andrey-belokon/Syntez_Si5351_Si570/README.md

Stand With Ukraine (https://stand-with-ukraine.pp.ua)
<h2>Universal Digital VFO Si570/Si5351</h2>

Oscillator - Si570 and/or Si5351<br>
CPU - Arduino Nano 5v ATMEGA328<br>
Display:<br>
  2.8" SPI TFT ILI9341<br>
  1.8" SPI TFT ST7735<br>
  LCD 1602<br>
  OLED 0.91" 128x32, OLED 0.96" 128x64, OLED 1.3" 128/132x64<br>
Realtime clock - DS3231(preffered) or DS1307(TinyRTC) or PCF8563<br>
Keyboard, BPF & other - PCF8574<br>
Rotary encoder - optical 360-400 pulse/turn or mechanical 20 pulse/turn

Allow any combination of two Si5351 and one Si570: Si5351, Si570, Si5351+Si5351, Si570+Si5351, Si570+Si5351+Si5351.<br>
Dual VFO A/B, SPLIT, RIT.<br>
Save current freq and band to EEPROM. <br>
CAT-enabled (Kenwood protocol).<br><br>
Support different TRX architecture:<br>
 1. Single and double IF superheterodyne.
 2. Up-conversion with general coverage 2-30MHz and high IF.
 3. Direct conversion with 2x or 4x output.
 4. Direct conversion with quadrature output.

Project homepage http://www.ur5ffr.com/viewtopic.php?t=174

Required libraries:<br>
 1. PDQ GFX with packed font support https://github.com/andrey-belokon/PDQ_GFX_Libs. You need install PDQ_GFX, PDQ_ILI9341 and PDQ_ST7735<br>
 2. UR5FFR_Si5351 https://github.com/andrey-belokon/UR5FFR_Si5351
 3. SSD1306Ascii - install from Arduino IDE

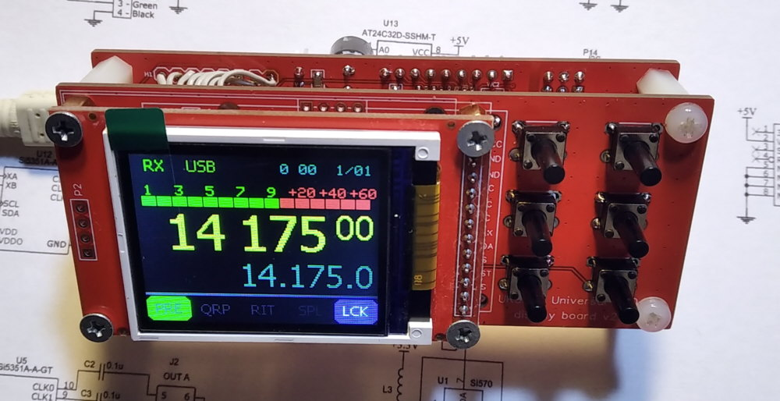
[picture p1: doc/ST7735_570_5351_two_plate/img/synt_v2_tft-10pin.jpg]

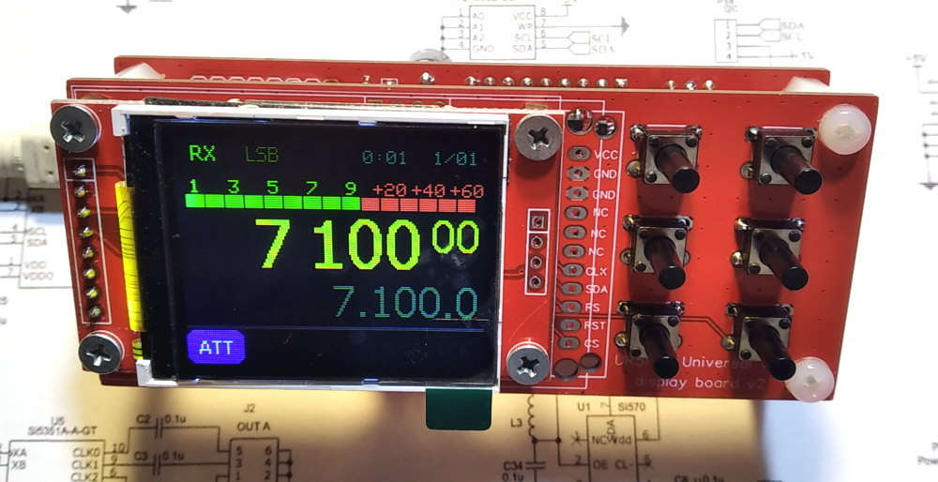
[picture p2: doc/ST7735_570_5351_two_plate/img/synt_v2_tft-8pin.jpg]

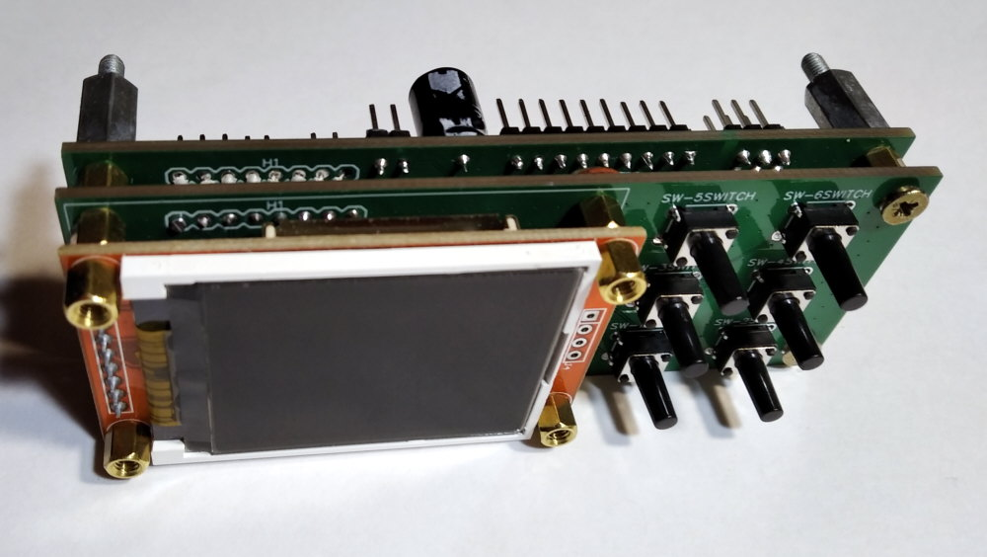
[picture p3: doc/ST7735_570_5351_two_plate/img/synt_1.8_9.jpg]

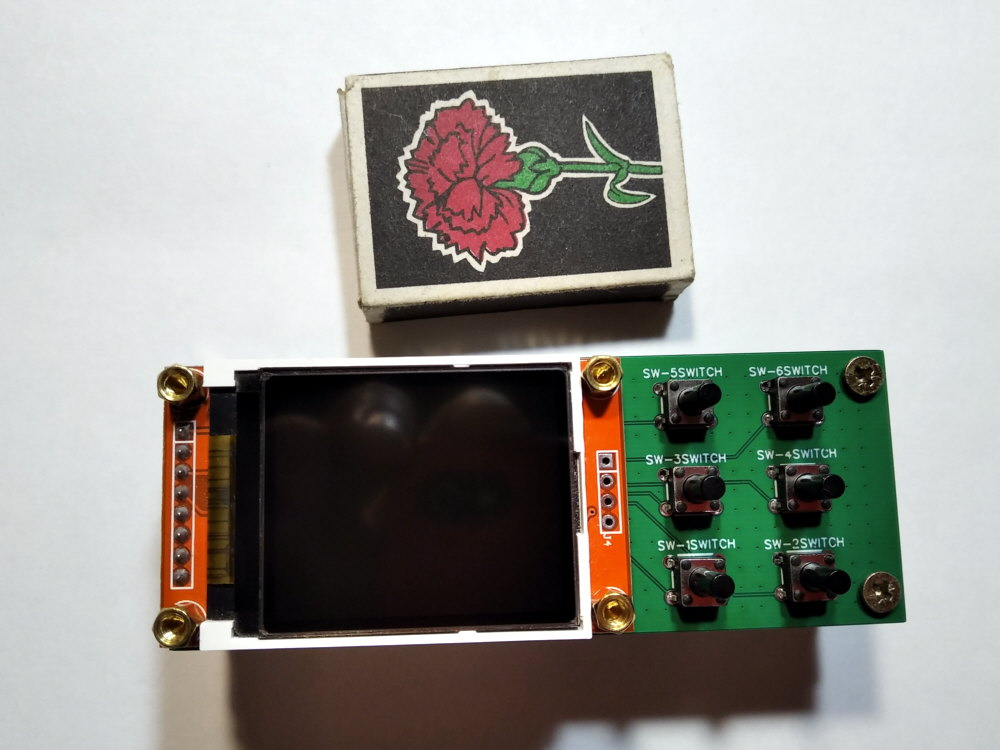
[picture p4: doc/ST7735_570_5351_two_plate/img/synt_1.8_4.jpg]

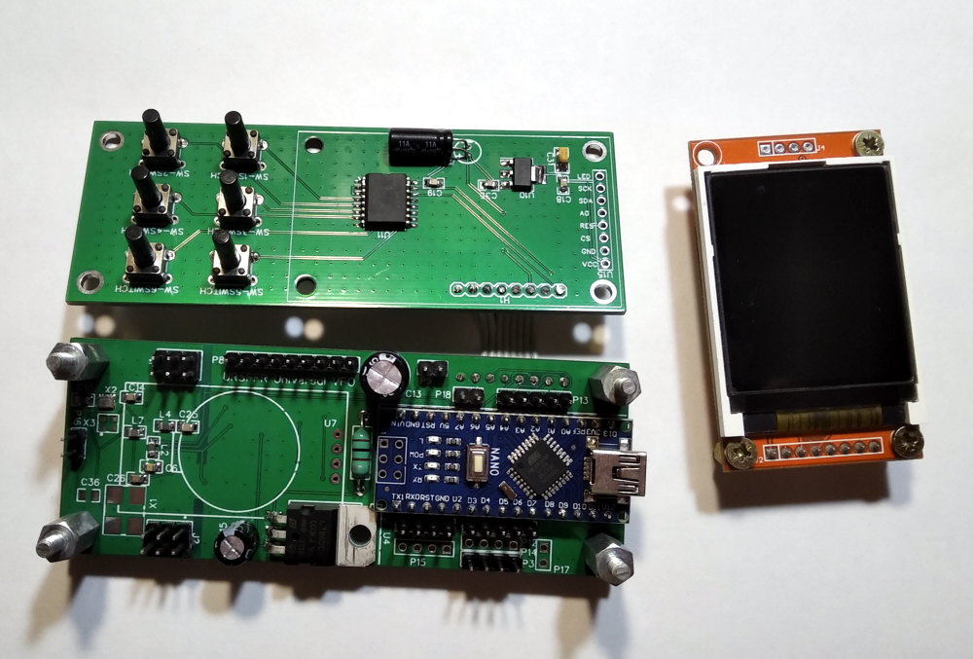
[picture p5: doc/ST7735_570_5351_two_plate/img/synt_1.8_7.jpg]


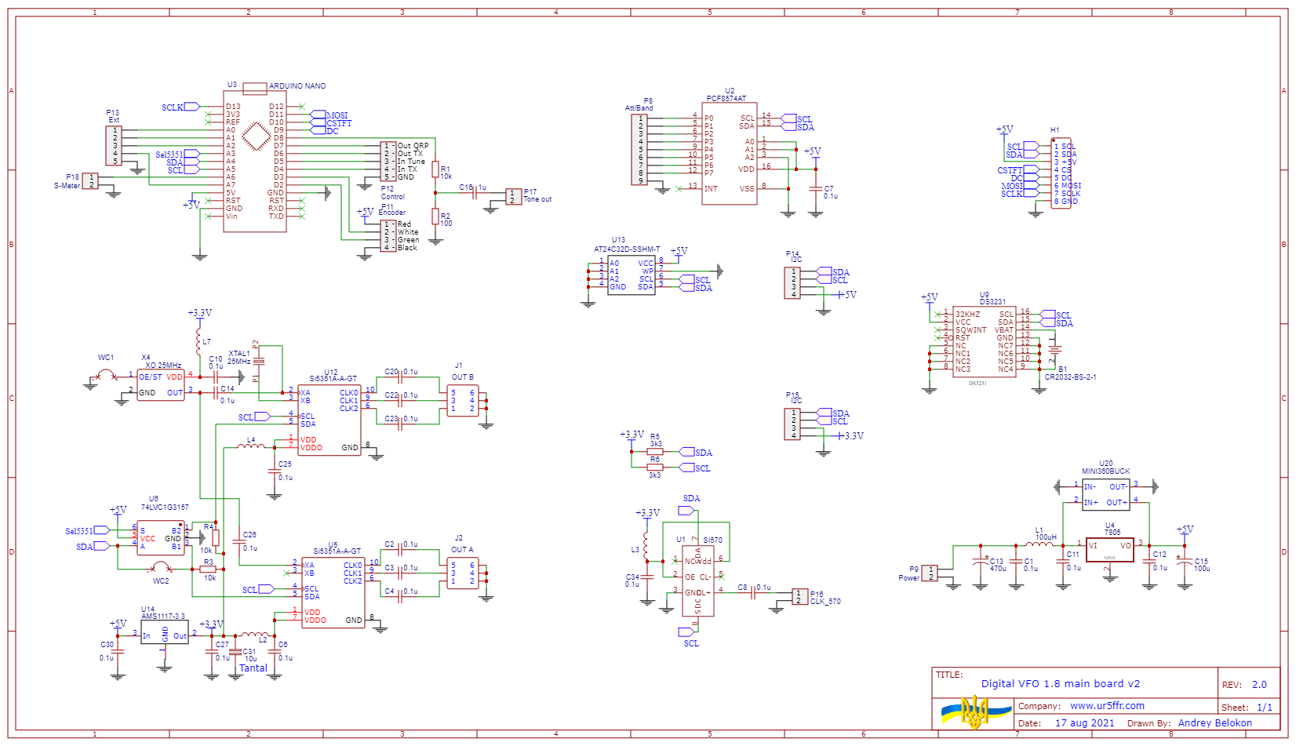
[picture p6: doc/ST7735_570_5351_two_plate/Schematic_Digital VFO 1.8 main board 2.0.png]

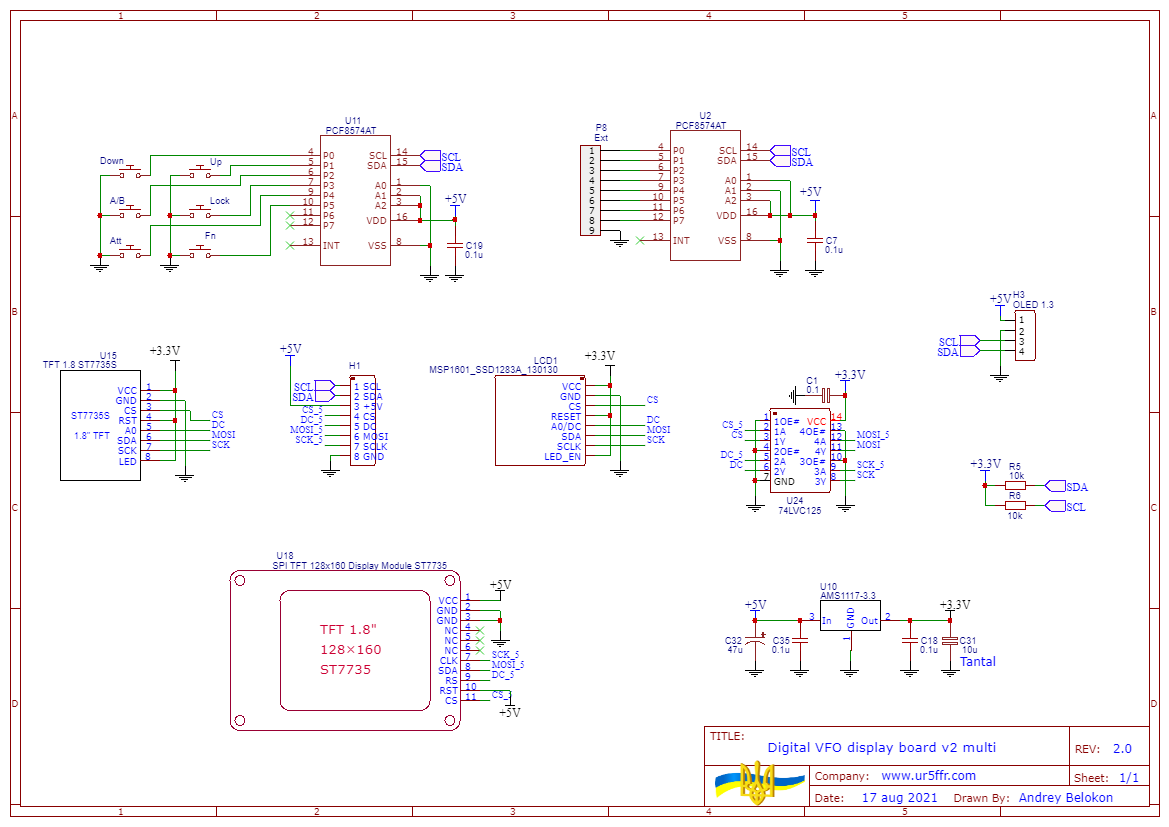
[picture p7: doc/ST7735_570_5351_two_plate/Schematic_Digital VFO 1.8 display board 2.0.png]


Copyright (c) 2016-2020, Andrii Bilokon, UR5FFR
License GNU GPL, see license.txt for more information
