andrey-belokon/Syntez_Si5351_Si570/doc/as5600_encoder.png

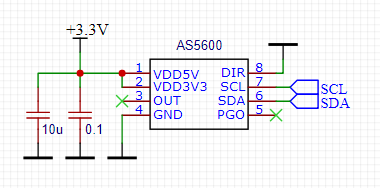
doc/as5600_encoder.png
