andrey-belokon/Syntez_Si5351_Si570/doc/Hardware/Band-control-I2C-LCD-adapter.png

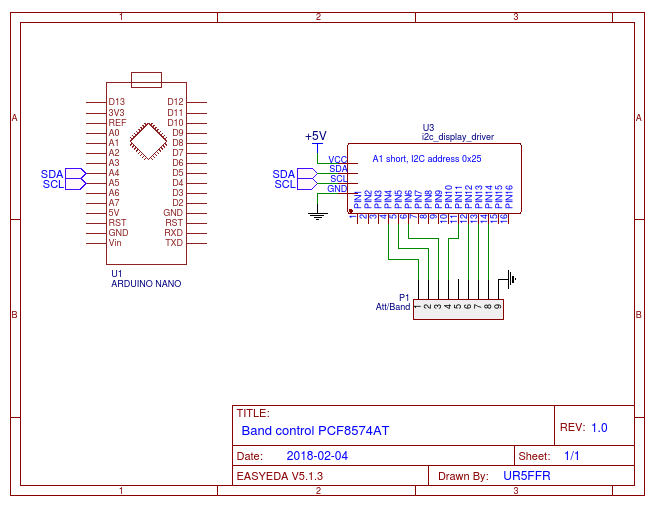
doc/Hardware/Band-control-I2C-LCD-adapter.png
