andrey-belokon/Syntez_Si5351_Si570/doc/Hardware/Band-control-PCF8574AT.png

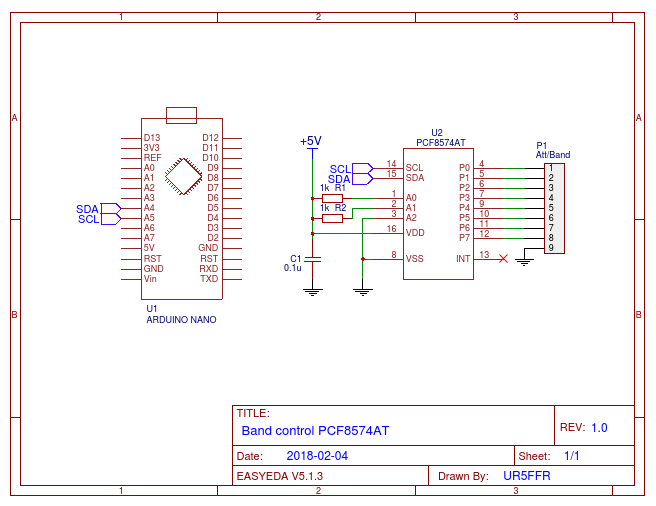
doc/Hardware/Band-control-PCF8574AT.png
