andrey-belokon/Syntez_Si5351_Si570/doc/Hardware/CPU-Pins.png

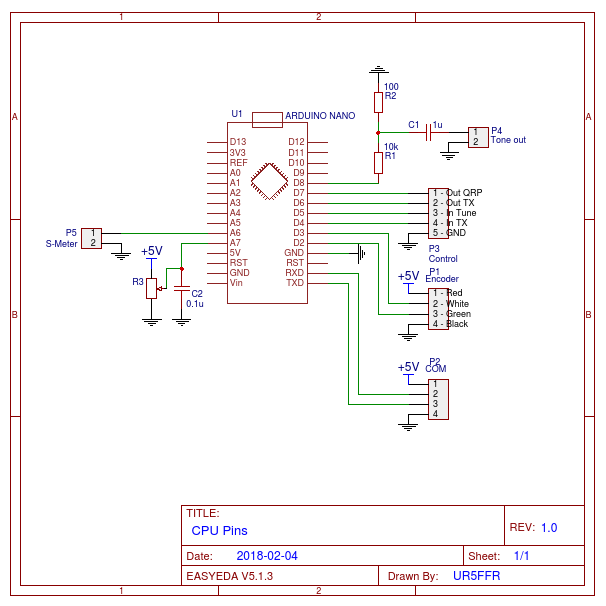
doc/Hardware/CPU-Pins.png
