andrey-belokon/Syntez_Si5351_Si570/doc/Hardware/Display-ILI9341.png

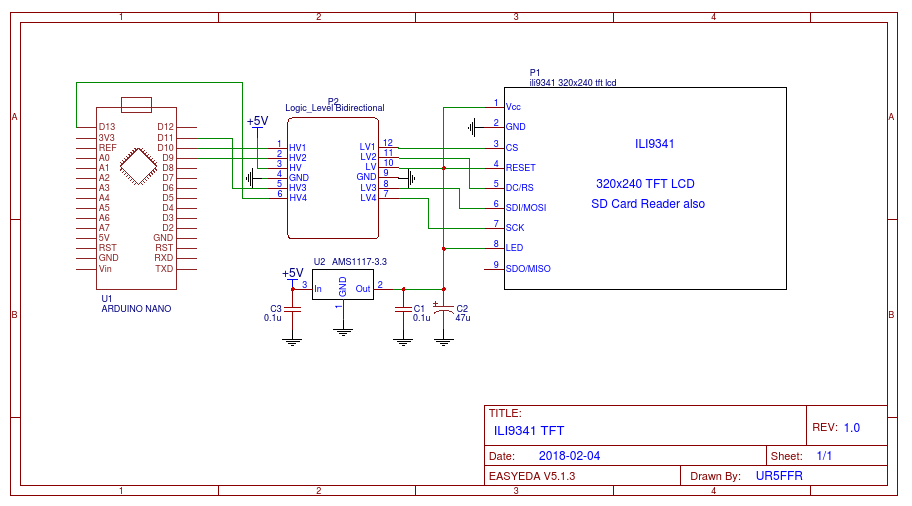
doc/Hardware/Display-ILI9341.png
