andrey-belokon/Syntez_Si5351_Si570/doc/Hardware/Display-LCD1602-I2C.png

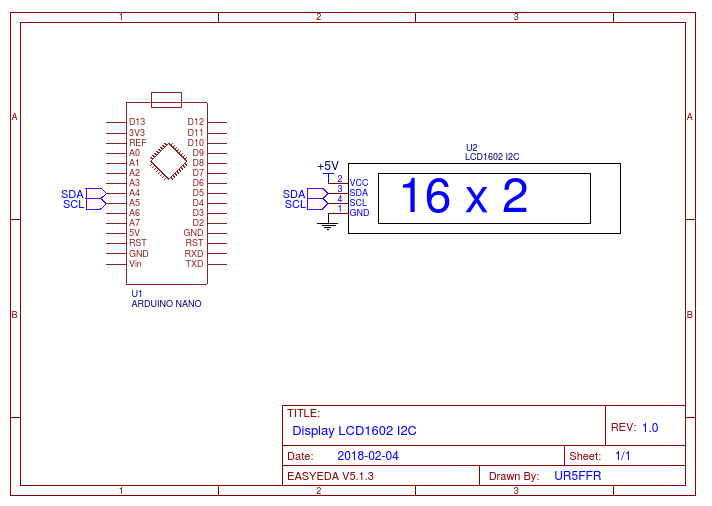
doc/Hardware/Display-LCD1602-I2C.png
