andrey-belokon/Syntez_Si5351_Si570/doc/Hardware/Display-ST7735.png

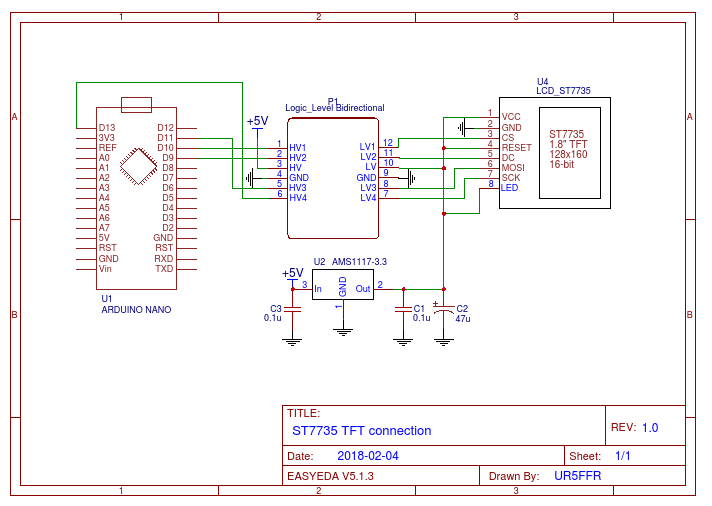
doc/Hardware/Display-ST7735.png
