andrey-belokon/Syntez_Si5351_Si570/doc/Hardware/EEPROM-24C32.png

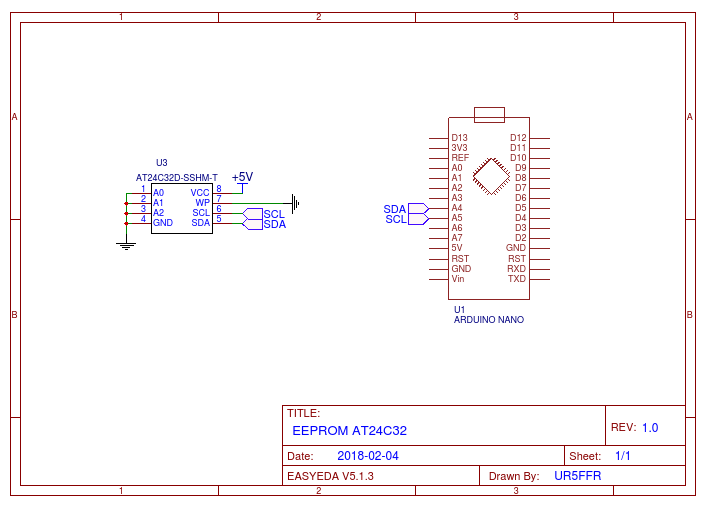
doc/Hardware/EEPROM-24C32.png
