andrey-belokon/Syntez_Si5351_Si570/doc/Hardware/Keypad-7-buttons.png

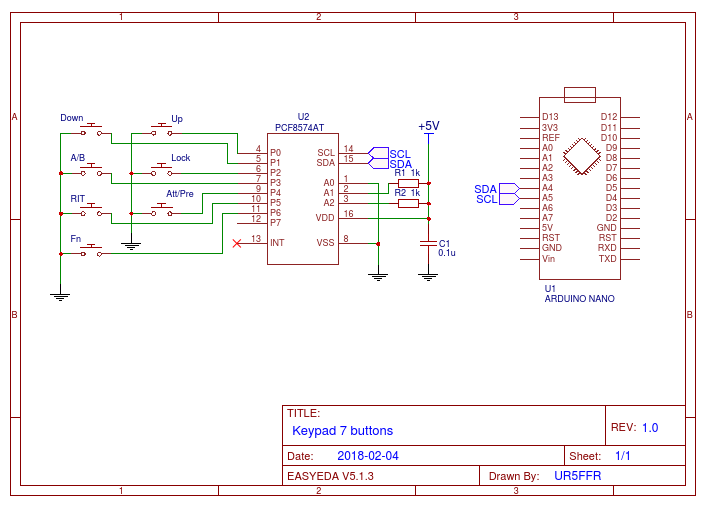
doc/Hardware/Keypad-7-buttons.png
