andrey-belokon/Syntez_Si5351_Si570/doc/Hardware/Keypad-12-buttons-3x4.png

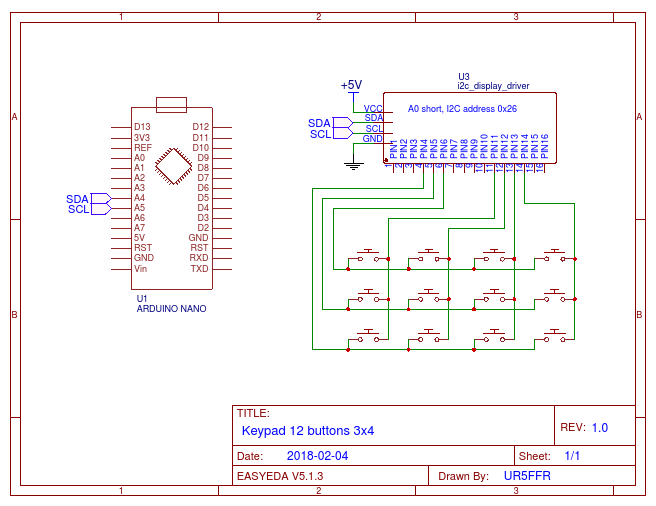
doc/Hardware/Keypad-12-buttons-3x4.png
