andrey-belokon/Syntez_Si5351_Si570/doc/Hardware/Level-translation.png

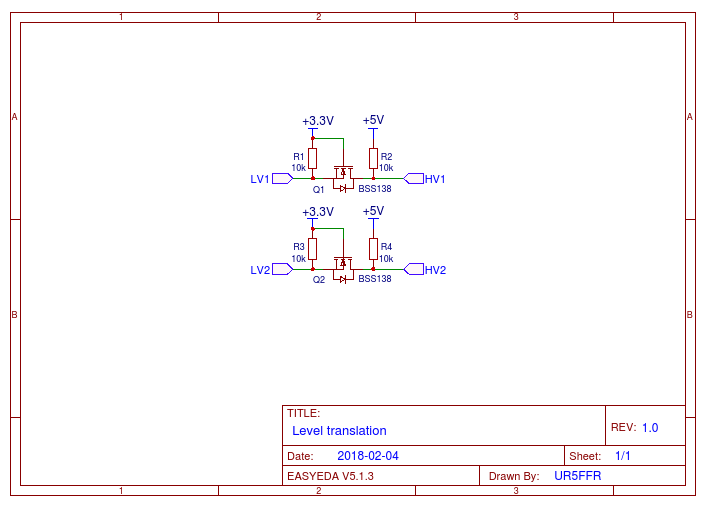
doc/Hardware/Level-translation.png
