andrey-belokon/Syntez_Si5351_Si570/doc/Hardware/Si570.png

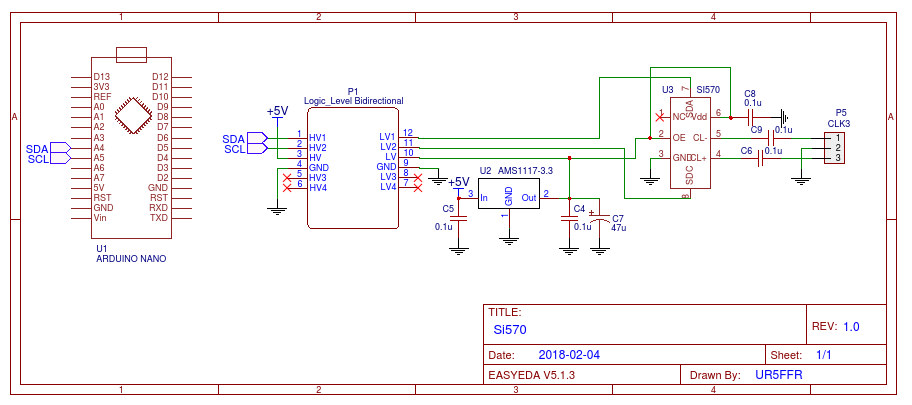
doc/Hardware/Si570.png
