andrey-belokon/Syntez_Si5351_Si570/doc/Hardware/Si5351.png

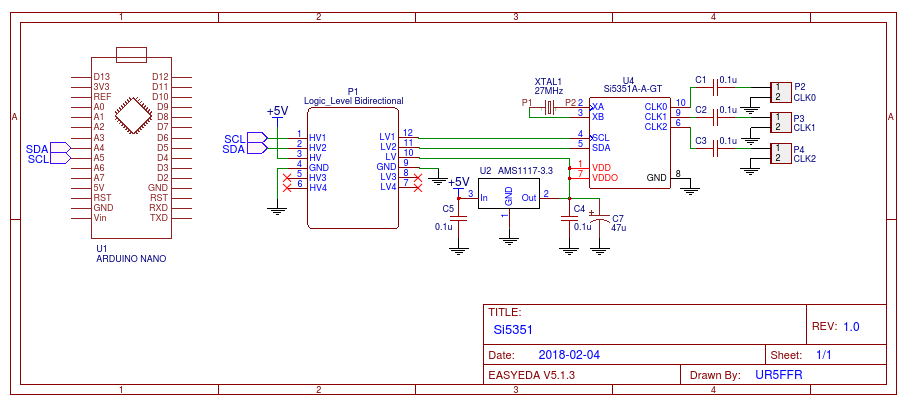
doc/Hardware/Si5351.png
