andrey-belokon/Syntez_Si5351_Si570/doc/Hardware/TinyRTC.png

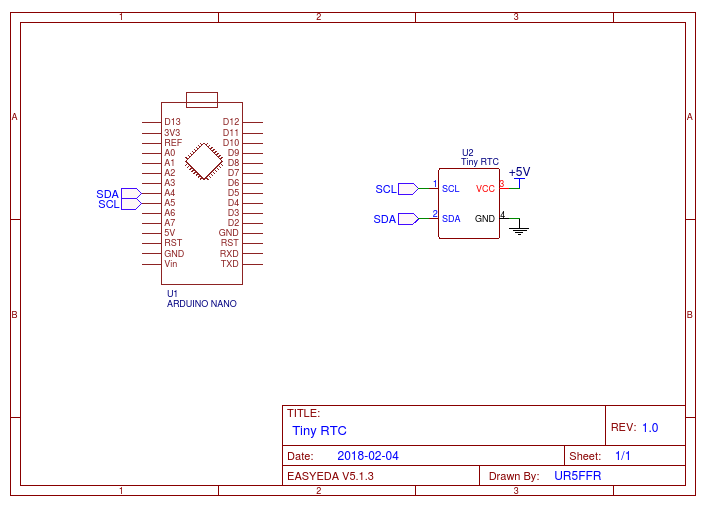
doc/Hardware/TinyRTC.png
