andrey-belokon/Syntez_Si5351_Si570/doc/ILI9341_570_5351_two_plate/Si5351-Syntez-Interface.png

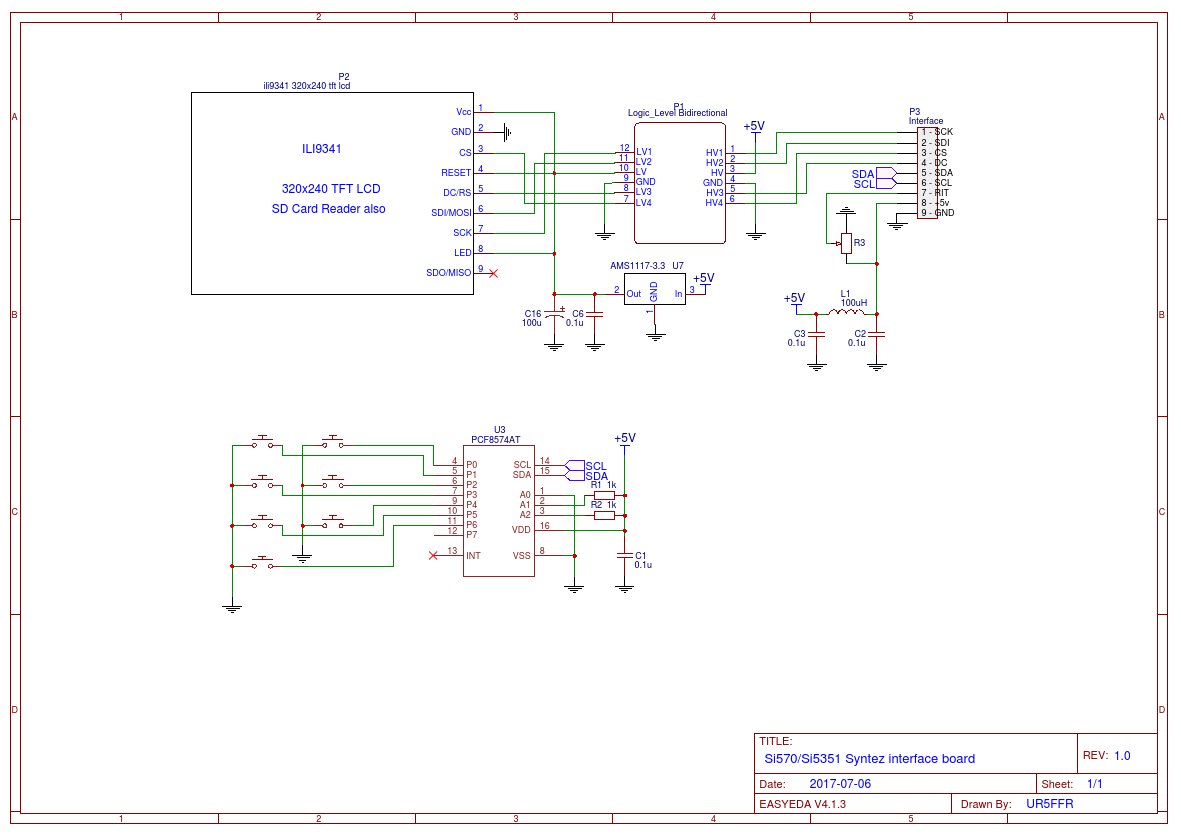
doc/ILI9341_570_5351_two_plate/Si5351-Syntez-Interface.png
