andrey-belokon/Syntez_Si5351_Si570/doc/Multi-display board/oled_small.jpg

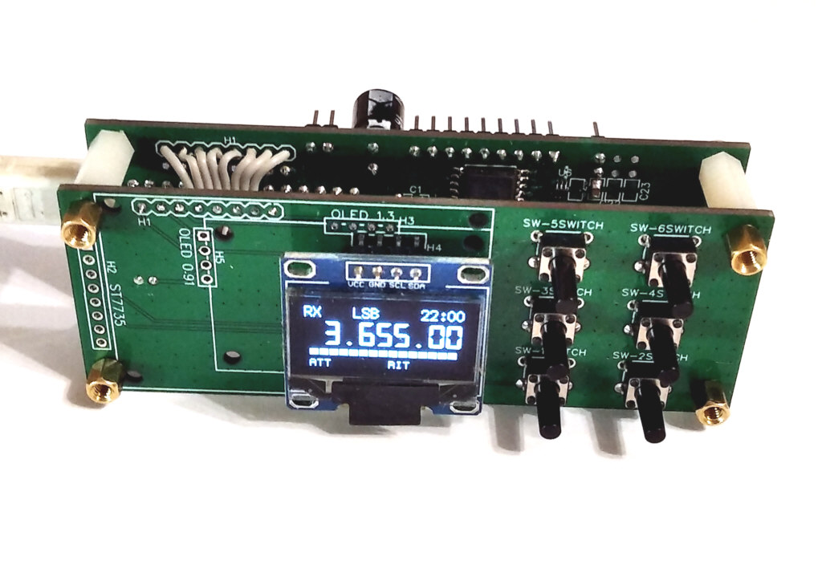
doc/Multi-display board/oled_small.jpg
