andrey-belokon/Syntez_Si5351_Si570/doc/Multi-display board/Schematic_Digital-VFO-1.8-display-board_2020-07-21_10-21-31.png

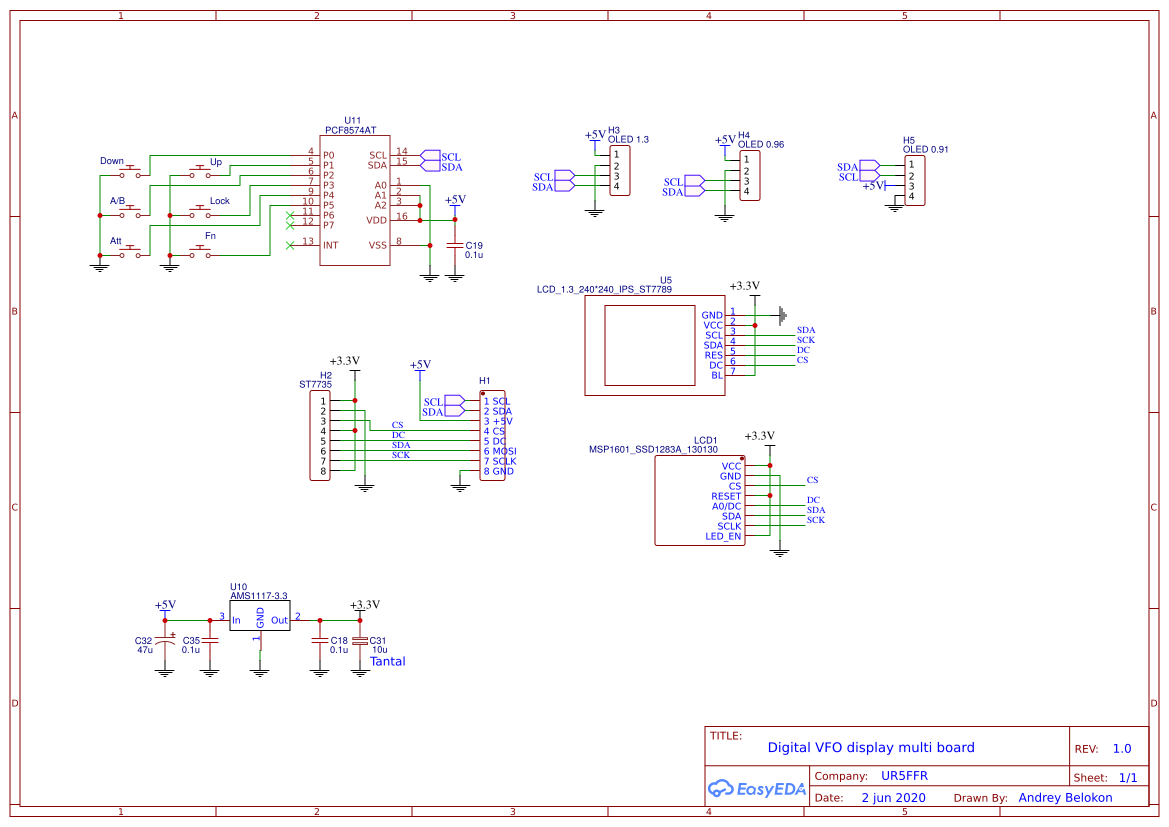
doc/Multi-display board/Schematic_Digital-VFO-1.8-display-board_2020-07-21_10-21-31.png
