andrey-belokon/Syntez_Si5351_Si570/doc/OLED_128x64.jpg

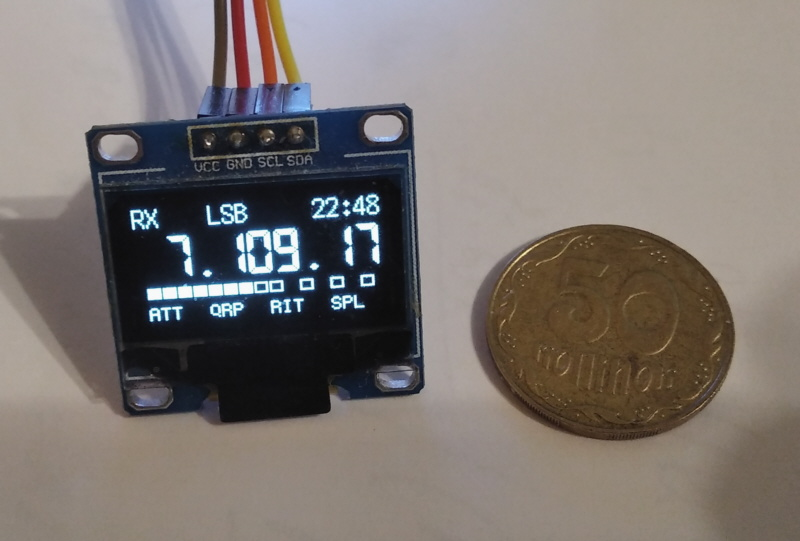
doc/OLED_128x64.jpg
