andrey-belokon/Syntez_Si5351_Si570/doc/ST7735_570_5351_two_plate/img/synt_v2_back.jpg

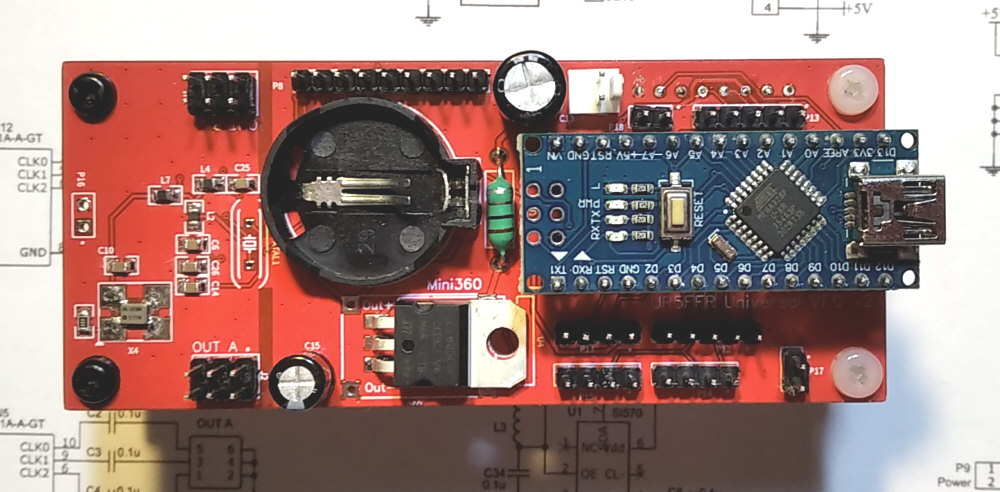
doc/ST7735_570_5351_two_plate/img/synt_v2_back.jpg
