andrey-belokon/Syntez_Si5351_Si570/doc/ST7735_570_5351_two_plate/Schematic Digital VFO 1.8 display board 1.0.png

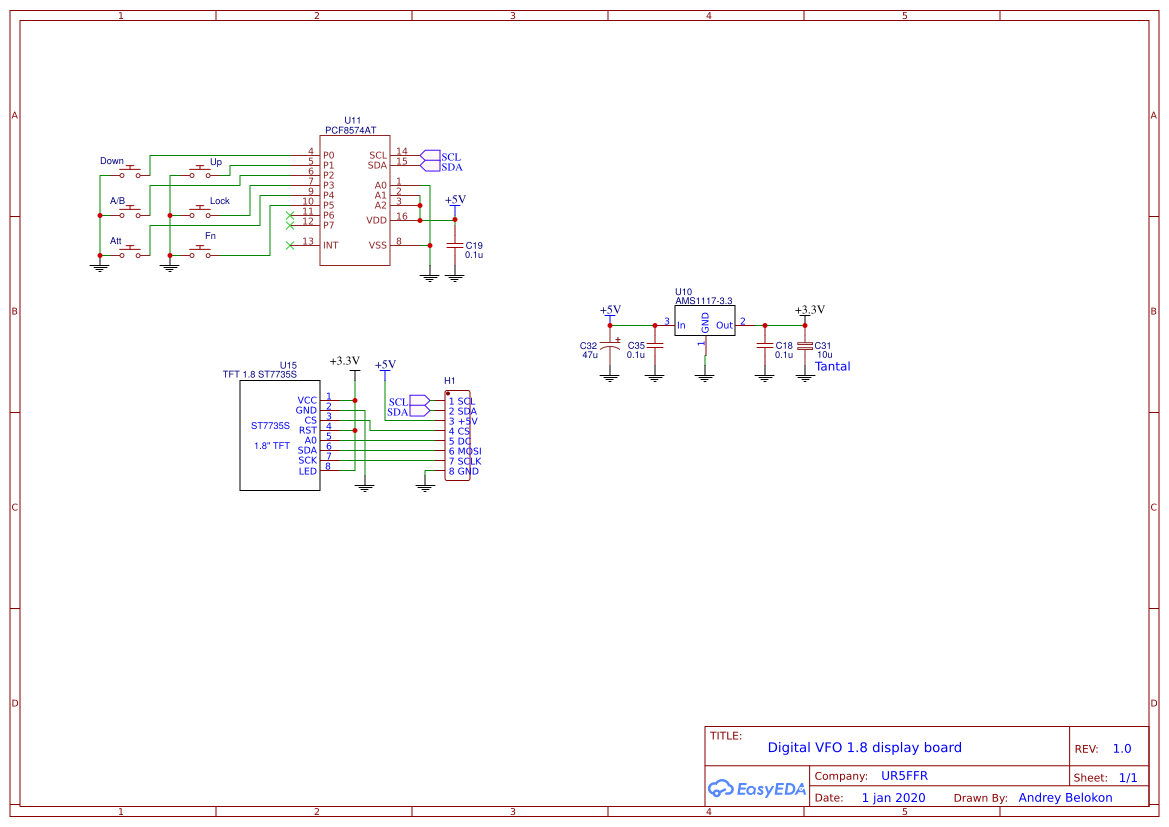
doc/ST7735_570_5351_two_plate/Schematic Digital VFO 1.8 display board 1.0.png
