andrey-belokon/Syntez_Si5351_Si570/doc/ST7735_570_5351_two_plate/Schematic Digital VFO 1.8 main board 1.3.png

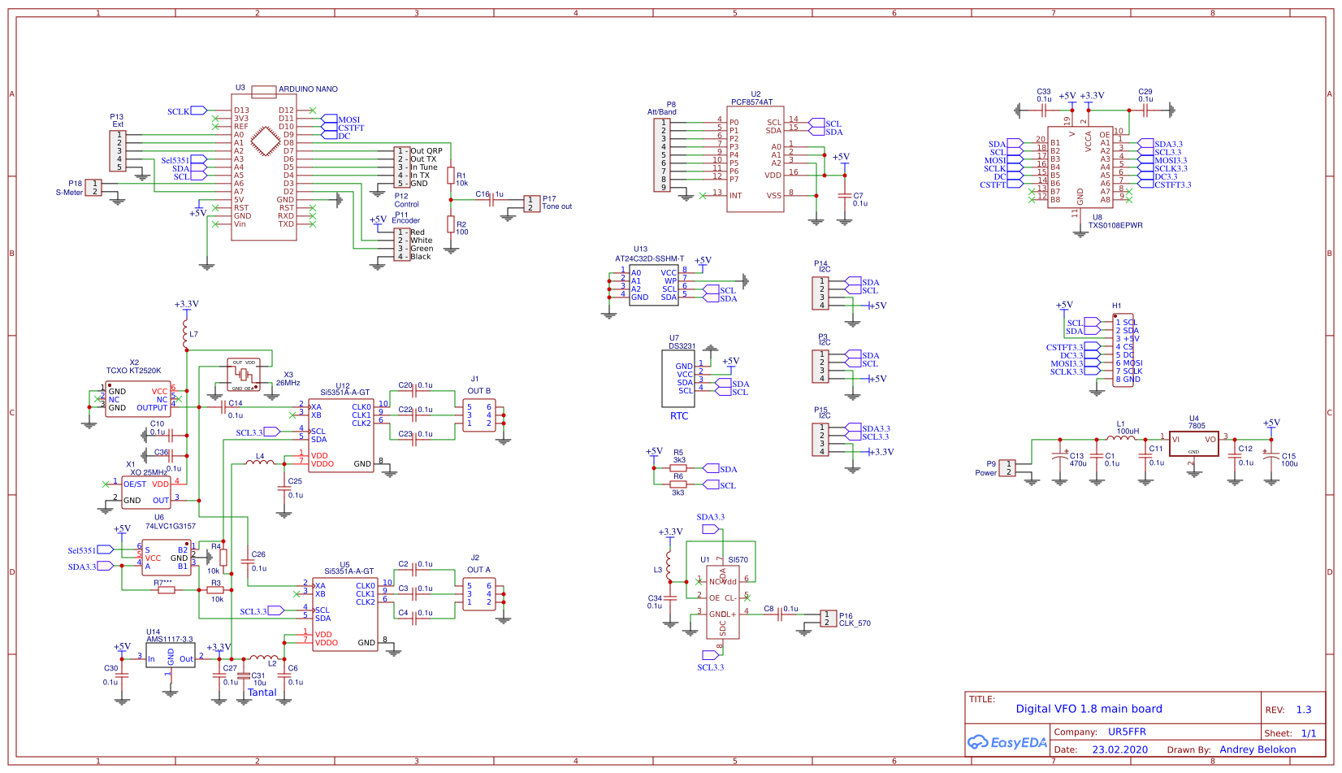
doc/ST7735_570_5351_two_plate/Schematic Digital VFO 1.8 main board 1.3.png
