andrey-belokon/Syntez_Si5351_Si570/doc/TFT_ILI9341.jpg

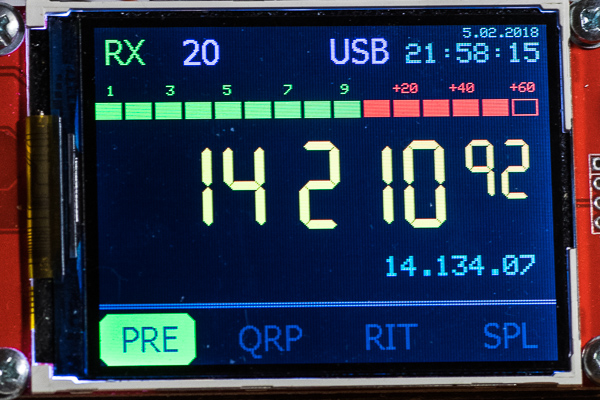
doc/TFT_ILI9341.jpg
