andrey-belokon/Syntez_Si5351_Si570/doc/TFT_ST7735.jpg

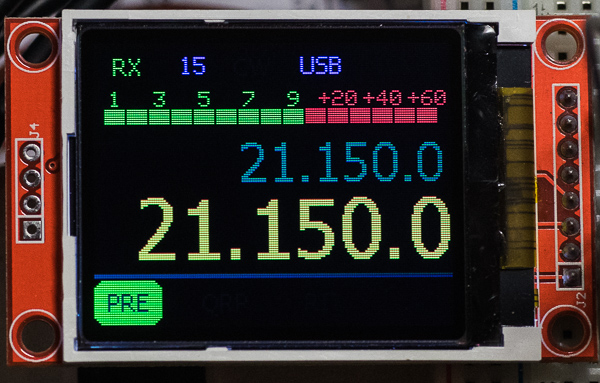
doc/TFT_ST7735.jpg
