andrey-belokon/Syntez_Si5351_Si570/history.txt

=======================================
Номер версии указан в начале Syntez.ino
=======================================

3.1		15.04.2020
- добавлена поддержка OLED 0.91" 128x32, OLED 0.96" 128x64, OLED 1.3" 128/132x64
  требуется установка библиотеки SSD1306Ascii

3.0		23.02.2020
- поддержка TFT ST7735 1.8"
- работа с двумя Si5351 и одной Si570 в произвольных комбинациях
- поддержка модулей realtime clock PCF8563 и DS3231
- оптимизирован код для работы с механическим валкодером с учетверением количества импульсов
- RIT перенесен с переменного резистора на валкодер
- добавлена поддержка различных мод (SSB/CW/AM/FM/etc). список мод и их параметры настраиваются к файле конфига
- возможность работы с "кривыми" Si5351 у которых наблюдаются проблемы с генерацией
- возможность изменять частоты BFO для каждой моды
- существенно переписан и оптимизирован код
- весь софт совместим и будет работать со всем ранее опубликованным "железом"

2.0		4.02.2018
- совместимость прошивки в проектом "Синтезатор из готовых модулей" http://dspview.com/viewtopic.php?f=22&t=162
- change frequency display to 7-segment led-style digits. Show 10x Hz. 
- add ST7735 1.8" TFT
- add LCD 1602
- add support for 12-buttons 3x4 keypad
- конфиг разделен на два модуля. все настройки "железа" вынесены в config_hw.h
- автосохранение будет работать при использовании 24C32 вместо TinyRTC
- обновлена документация. добавлены схемы подключения различных периферийных модулей
- в меню добавлена возможность коррекции частоты ПЧ в пределах +/-30kHz от заданной

1.1		6.08.2017
- изменены номера пинов для Att/Pre на 5й/6й
- на 7й пин выведено состояние CW для переключения фильтра

1.0		26.07.2017
General Coverage реализован как отдельный диапазон с запоминанием настроек в EEPROM
