andrey-belokon/Syntez_Si5351_Si570/(threads)

Thread 1 (2020-11-09):

5v Arduino ?

clclon, 2020-11-09:
Спасибо за отличные библиотеки, но хочется задать вопрос, из каких соображений используется Ардуино на 5 вольт?
Есть же полные аналоги на 3.3 вольта, и они не потребуют согласования с другими элементами. Рекомендую обратить внимание на серию Ардуин LGT, они вполне приемлимо работают на такое 32Мгц и являются полным аналогом Атмеги328. Применение их улучшит работу с дисплеем, по быстродействию.
