andrey-belokon/Syntez_Si5351_Si570/doc/ST7735_570_5351_two_plate/Schematic_Digital VFO 1.8 display board 2.0.pdf

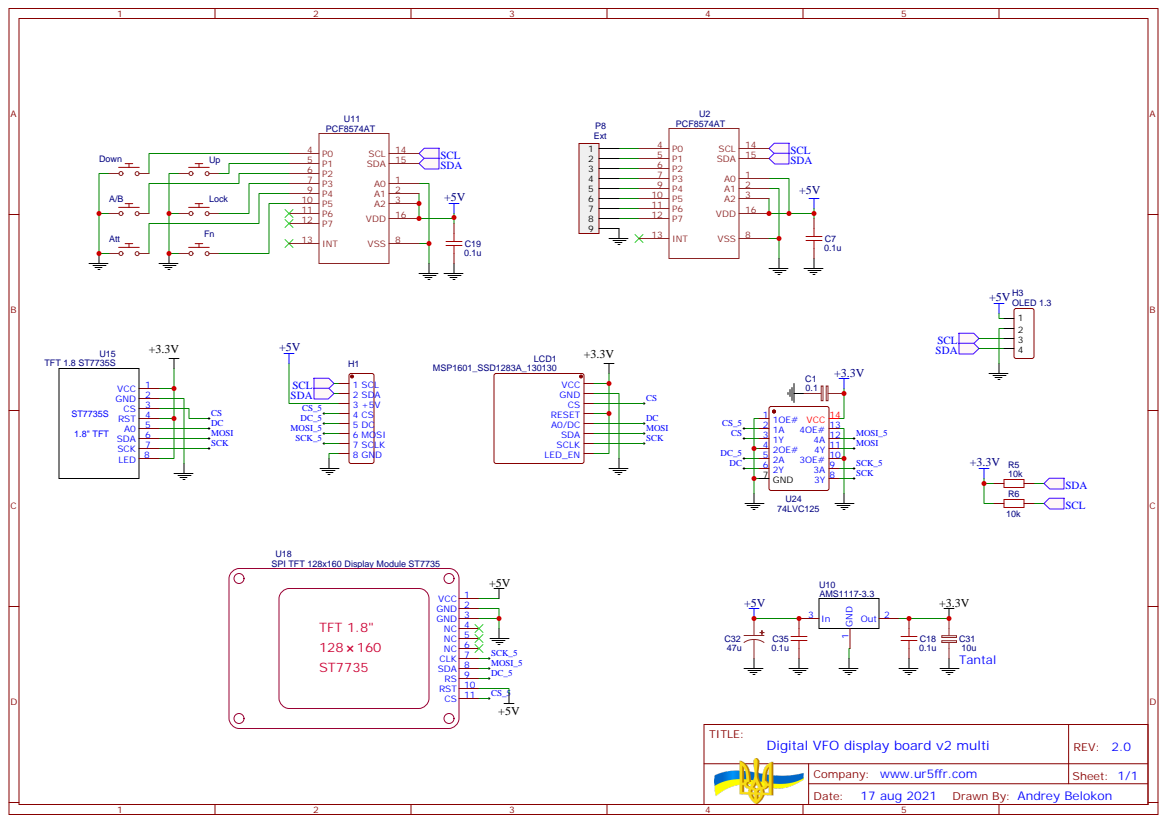
[picture p43: page 1]

SPI TFT 128x160 Display Module ST7735

Drawn By: Andrey Belokon
