andrey-belokon/Syntez_Si5351_Si570/doc/ST7735_570_5351_two_plate/Schematic Digital VFO 1.8 main board 1.3.pdf

+5V +3.3V

# B8 12 B7 13 B6 14 B5 15 B4 16 B3 17 B2 18

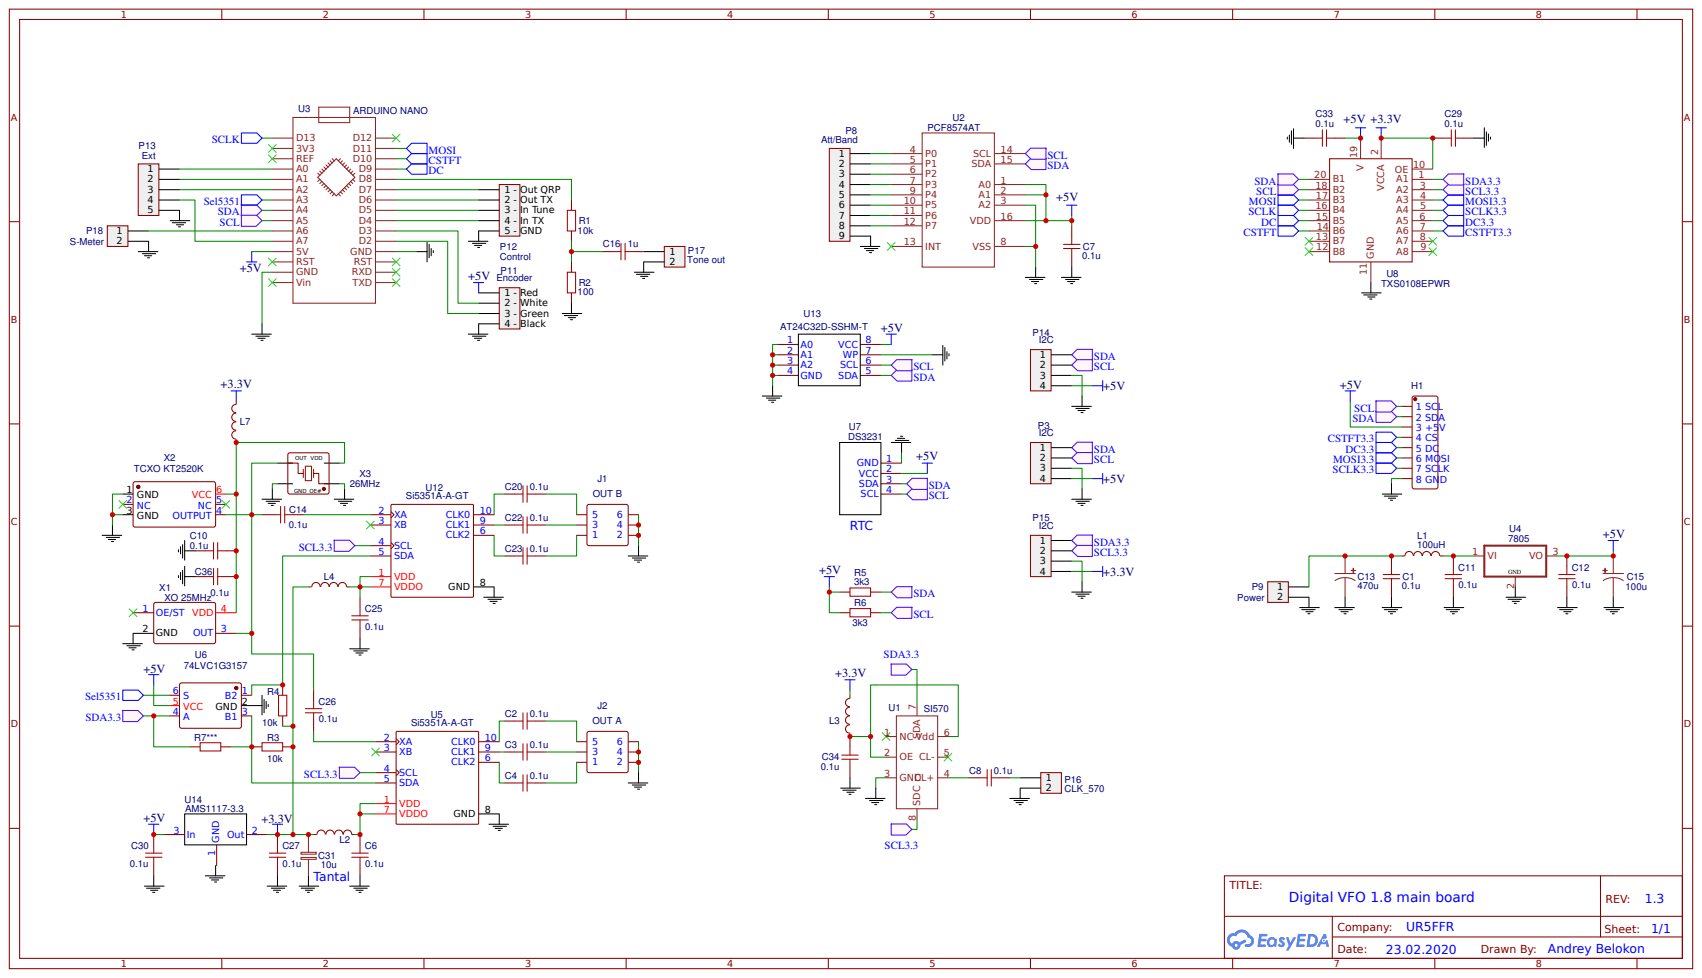
[picture p44: page 1]

Drawn By: Andrey Belokon
