andrey-belokon/Syntez_Si5351_Si570/doc/ST7735_570_5351_two_plate/Schematic Digital VFO 1.8 display board 1.0.pdf

+5V

# P7 12 P6 11 P5 10 P4 9 P3 7 P2 6 P1 5 P0 4

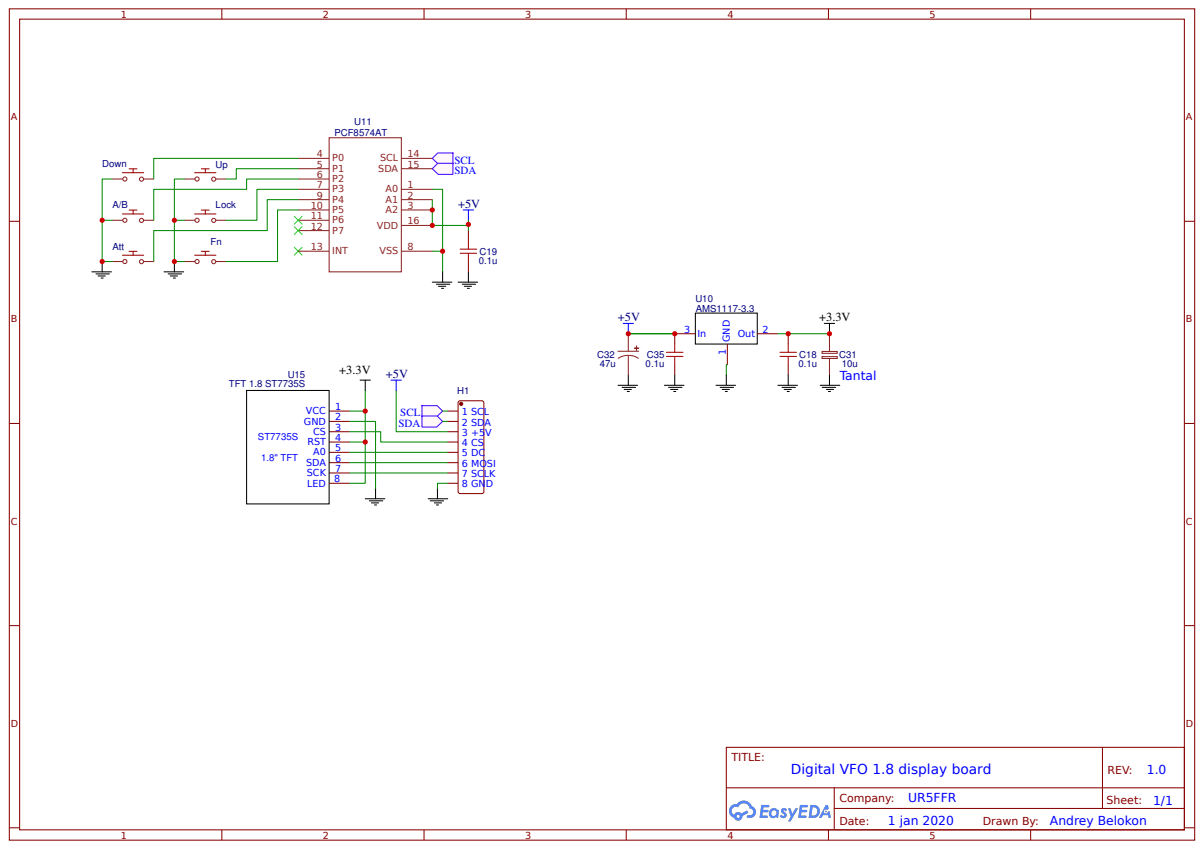
[picture p45: page 1]

Drawn By: Andrey Belokon
