andrey-belokon/Syntez_Si5351_Si570/doc/ST7735_570_5351_two_plate/Schematic_Digital VFO 1.8 main board 2.0.pdf

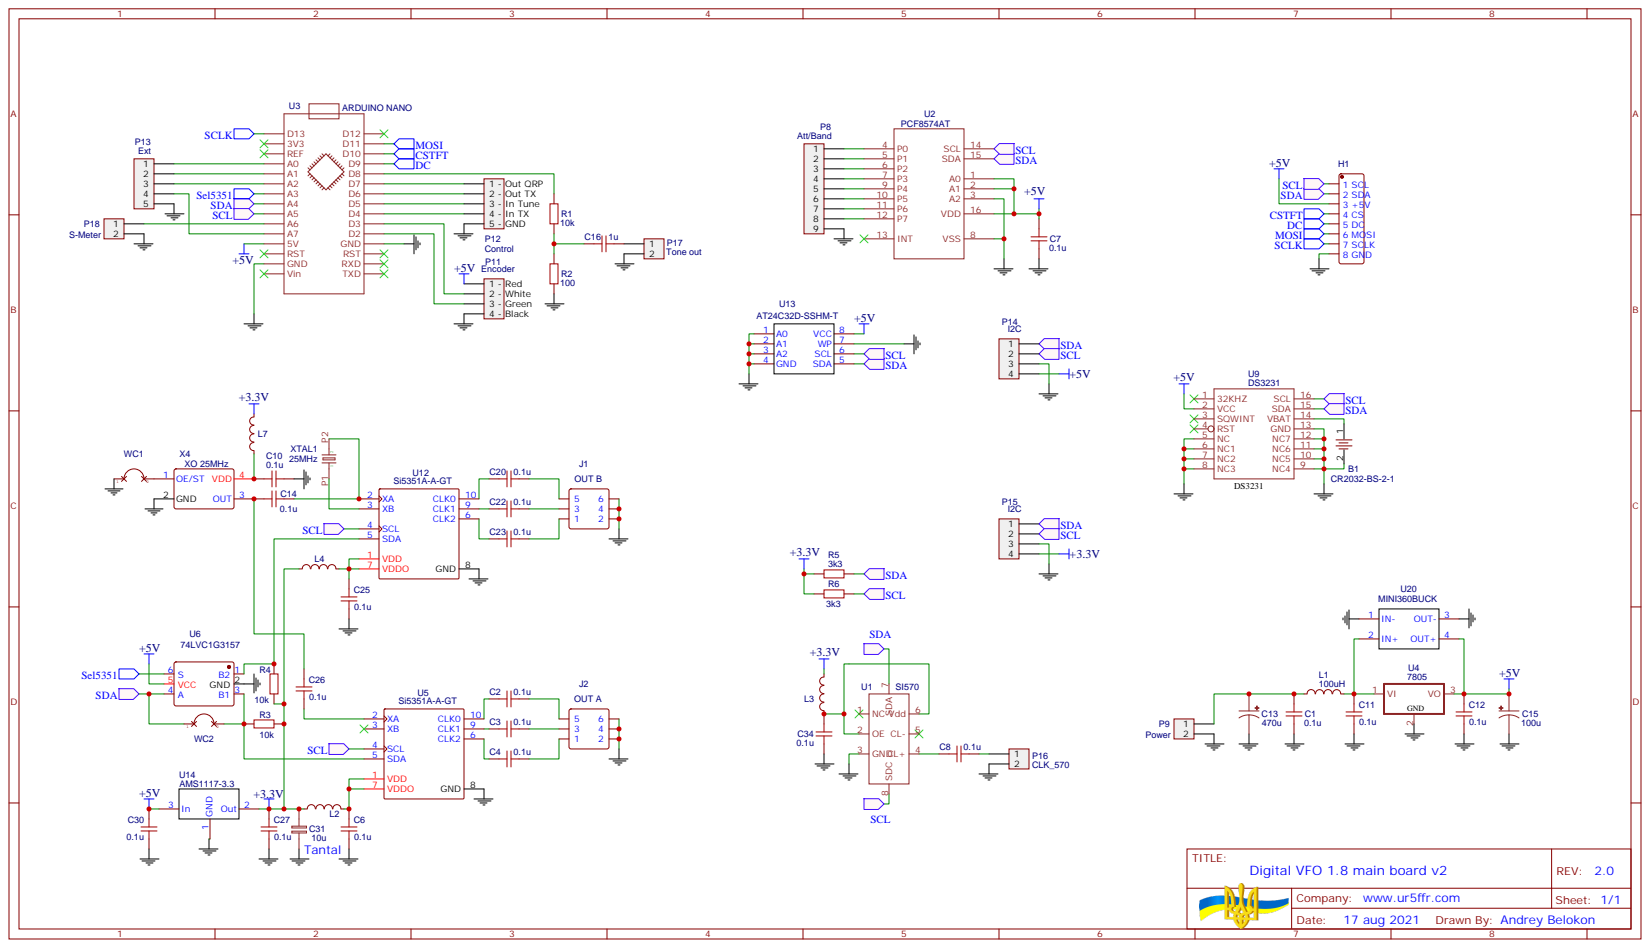
[picture p46: page 1]

Drawn By: Andrey Belokon
