andrey-belokon/Syntez_Si5351_Si570/doc/ILI9341_570_5351_two_plate/Si5351-Syntez-Interface.pdf

## 320x240 TFT LCD SD Card Reader also

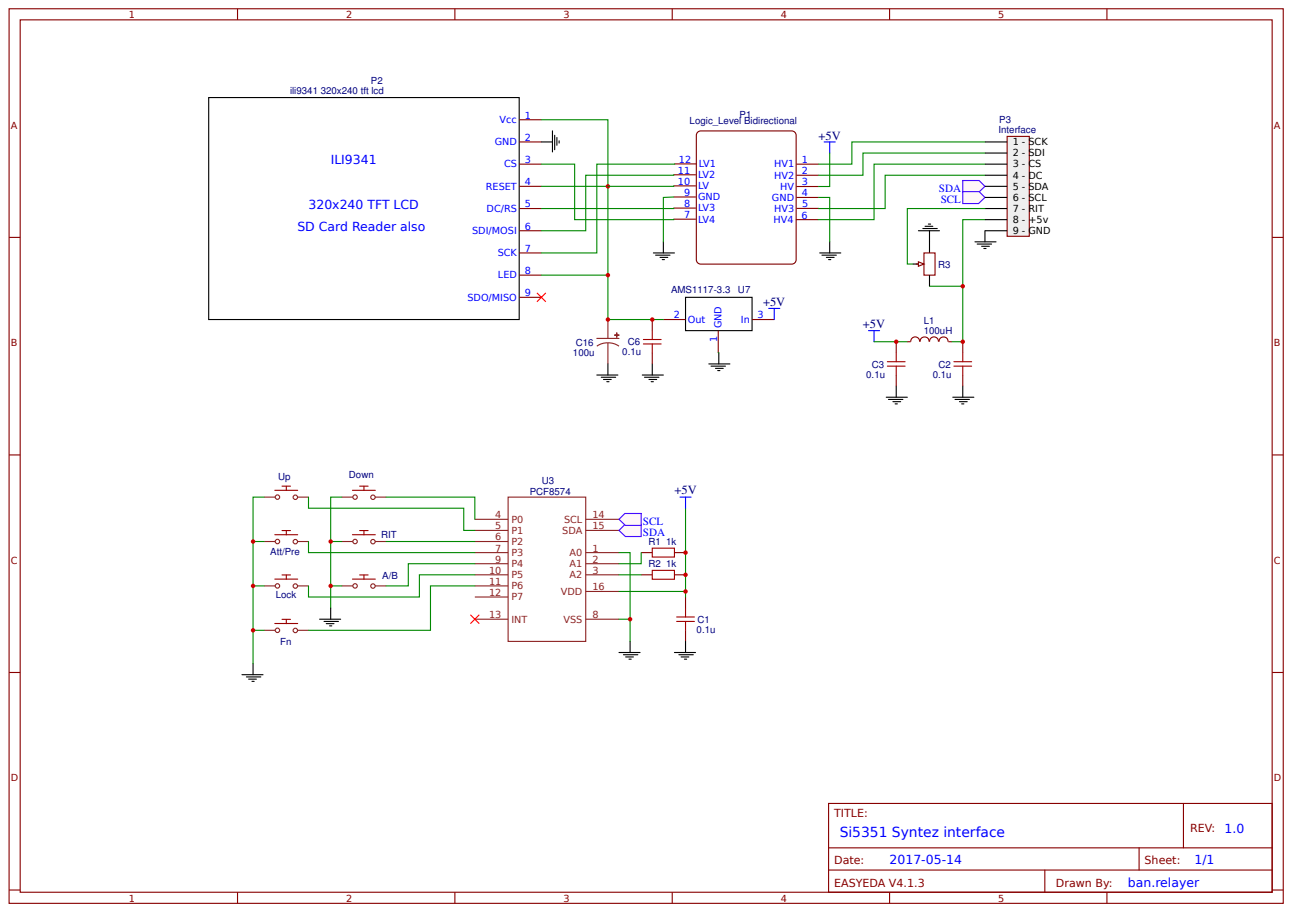
[picture p53: page 1]
