andrey-belokon/Syntez_Si5351_Si570/Syntez/disp_OLED128x32.h

#ifndef DISP_OLED12832_H
#define DISP_OLED12832_H

#include <Arduino.h>
#include "TRX.h"

#ifdef DISPLAY_OLED128x32

class Display_OLED128x32 {
  public:
    void setup();
    // 1..15
    void setBright(uint8_t brightness);
    void Draw(TRX& trx);
    void clear();
    void reset();
    void DrawMenu(const char* title, const char** items, uint8_t selected, const char* help, uint8_t fontsize);
};

#endif

#endif
