andrey-belokon/Syntez_Si5351_Si570/(commit log)

2017-07-03 10x step Fn+валкодер
2017-07-04 убрал неиспользуемые регистры в Si570
2017-07-04 калибровка Si570
2017-07-04 переделал калибровку
2017-07-05 переупорядочил кнопки вызов меню по двойному нажатию
2017-07-06 Fn - везде выход из меню в меню проверить длины буферов для текстов
2017-07-06 переупорядочены клавиши
2017-07-06 запрет квадратуры если не установлена 5351
2017-07-07 документация
2017-07-07 автоматический выбор направлени отсчета S-метра
2017-07-13 вынес настройки энкодера в конфиг
2017-07-16 bug in Si570 calibration
    [config.h]
2017-07-26 General Coverage реализован как отдельный диапазон с запоминанием настроек в EEPROM
2017-08-05 - изменены номера пинов для Att/Pre на 5й/6й - на 7й пин выведено состояние CW для переключения фильтра
2017-08-10 вывод частоты калибровки на все выходы Si5351. корректный сброс RDIV
2017-08-10 раздельный ресет PLL_A/PLL_B
2017-08-12 возврат флага ресета PLL Si5351
2017-10-09 переполнение разрядности
2018-01-31 Change frequency display to 7-segment led-style digits. Show 10x Hz. Remove unused fonts. Code size 28416 bytes, data size 1005 bytes
2018-02-01 вынес I2C адреса и номера пинов в конфиг
2018-02-02 разделил конфиги. возможность работать без клавиатуры/дисплея/энкодера
2018-02-03 added sideband pin
2018-02-04 вынести в меню точную настройку частоты ПЧ
2018-02-06 добавил часы в LCD 1602 и ST7735 автоматическое снятие блокировки при bandUp/Down в режиме general coverage. добавил TFT_ORIENTATION. вынес указание варианта ST7735 в config_hw
2018-02-08 нативная реализация генерации тона 1кГц. задействован TIMER2. экономия ~1kb кода
2018-02-09 мусор при отрисовке RIT
2018-05-08 механический валкодер
2018-05-08 конфиг
2018-05-09 глюки энкодера
2019-03-17 автовыбор используемой боковой при двойном преобразовании
2019-03-17 si5351 - возможность задания VCO min/max )критично для "левых" 5351 которые требуют работы при пониженном VCOMax)
2019-03-20 оптимизация
2019-12-04 Universal CPU board rev 1.0
2019-12-18 Switch to Si5351 library https://github.com/andrey-belokon/UR5FFR_Si5351
2019-12-22 Клава, оптимизация пулинга ацп, вычистил варнинги
2019-12-24 оптимизация, варнингм. второй Si5351
2019-12-24 убрал MAX7219
2019-12-24 Статическая реализация энкодера
2020-02-13 добавлен механический энкодер. переписана реализация оптического
2020-02-13 убрал установку сек в меню
2020-02-14 длинные нажатия кнопок
2020-02-15 настраиваемые моды. убрал авто-CW
2020-02-15 формирование частот
2020-02-15 сокращенная настройка S-метра
2020-02-19 lsb|usb отдельными модами без sideband
2020-02-20 пробел в часах между датой и временм
2020-02-20 десятки Hz у 7735
2020-02-20 A|B не меняются местами при отображении
2020-02-20 индикация ham/gc
2020-02-23 Select Si5351 by pin A3. Update shematic
2020-03-23 unstable analog read assign cmdMode for keyboard 12
    [Keypad_12_I2C.cpp, pins.cpp]
2020-04-11 minor bugfix in mechanical encoder code
    [Encoder.cpp, TRX.cpp, config_hw.h]
2020-05-01 Invalid frequency when specify only USB or LSB filter
2020-06-03 новая версия 1.1 библиотеки SI5351/SI570
2020-06-09 при изменении мод неправильно загружаются данные из EEPROM
2020-07-28 update display board documentation
2020-11-19 ошибка в реализации cat
2020-11-24 CAT не выставлял частоту
2021-03-02 Сократил размер прошивки на 1.2к если не используется OLED
2021-03-05 Support for AS5600 encoder
2021-07-03 Частота tone в два раза ниже
2021-11-01 AnalogRead bugfix in pins
    [pins.cpp]
2021-11-12 версия 2.0
2022-02-20 - Support FT-817 CAT protocol - add RX/TX switch (PTT) via CAT
2022-03-15 correct address 24C32 for v2 PCB
    [config_hw.h]
